lagrandecode/esp-drone-s3-pcb/production/render_bottom.png

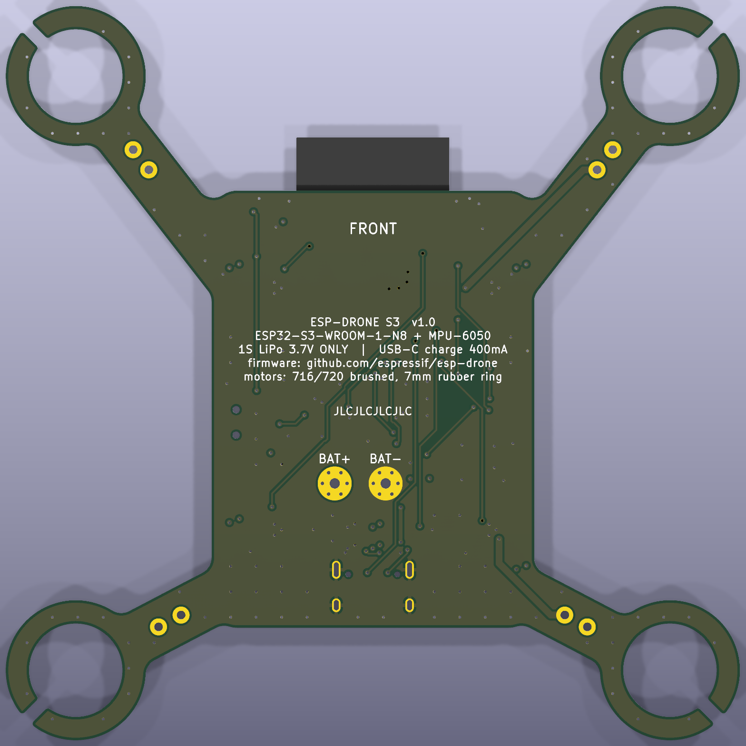
production/render_bottom.png
