lagrandecode/esp-drone-s3-pcb/production/render_iso.png

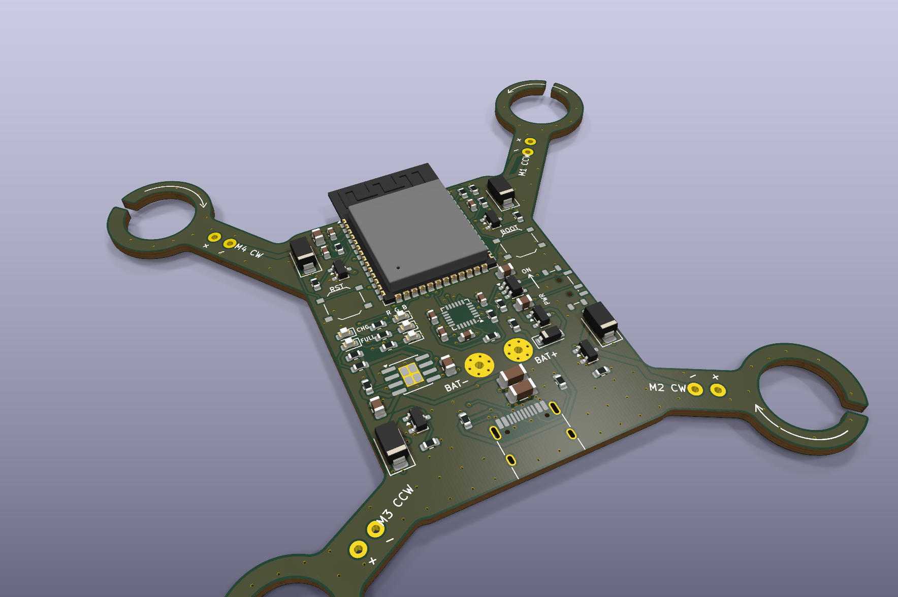
production/render_iso.png
