lagrandecode/esp-drone-s3-pcb/production/esp_drone_s3_bom.csv

Comment | Designator | Footprint | LCSC Part # | Quantity
1uF | C1 | C_0603_1608Metric | C15849 | 1
22uF | C2 | C_0805_2012Metric | C45783 | 1
100nF | C3,C10,C12,C14 | C_0603_1608Metric | C14663 | 4
10uF | C4,C5,C6,C7 | C_0805_2012Metric | C15850 | 4
47uF | C8,C9 | C_1206_3216Metric | C96123 | 2
10nF | C11 | C_0603_1608Metric | C57112 | 1
2.2nF | C13 | C_0603_1608Metric | C1604 | 1
SS34 | D1,D2,D3,D4 | D_SMA | C8678 | 4
B5819W | D5 | D_SOD-123 | C8598 | 1
USB-C | J1 | USB_C_Receptacle_HRO_TYPE-C-31-M-12 | C165948 | 1
RED | LED1,LED4 | LED_0603_1608Metric | C2286 | 2
GREEN | LED2,LED5 | LED_0603_1608Metric | C12624 | 2
BLUE | LED3 | LED_0603_1608Metric | C2288 | 1
AO3400A | Q1,Q2,Q3,Q4 | SOT-23 | C20917 | 4
AO3401A | Q5 | SOT-23 | C15127 | 1
5.1k | R1,R2 | R_0603_1608Metric | C23186 | 2
3k | R3 | R_0603_1608Metric | C4211 | 1
1k | R4,R5 | R_0603_1608Metric | C21190 | 2
470R | R6 | R_0603_1608Metric | C23179 | 1
100R | R7,R8 | R_0603_1608Metric | C22775 | 2
10k | R9,R10,R16,R17,R18,R19 | R_0603_1608Metric | C25804 | 6
4.7k | R11,R12 | R_0603_1608Metric | C23162 | 2
100k | R13,R14,R15,R20 | R_0603_1608Metric | C25803 | 4
BOOT/RESET | SW1,SW2 | SW_Push_1P1T_XKB_TS-1187A | C318884 | 2
POWER | SW3 | SW_SPDT_Shouhan_MSK12C02 | C431540 | 1
ESP32-S3-WROOM-1-N8 | U1 | ESP32-S3-WROOM-1 | C2913198 | 1
MPU-6050 | U2 | InvenSense_QFN-24_4x4mm_P0.5mm | C24112 | 1
TP4056 | U3 | SOIC-8-1EP_3.9x4.9mm_P1.27mm_EP2.41x3.3mm | C16581 | 1
AP2112K-3.3 | U4 | SOT-23-5 | C51118 | 1
