lagrandecode/esp-drone-s3-pcb/(list of files, drawings)

Other design files:
tools/easyeda_pads.json
