lagrandecode/esp-drone-s3-pcb/kicad/esp_drone_s3.kicad_pcb

## KiCad design kicad/esp_drone_s3.kicad_pcb (2026-11-05)

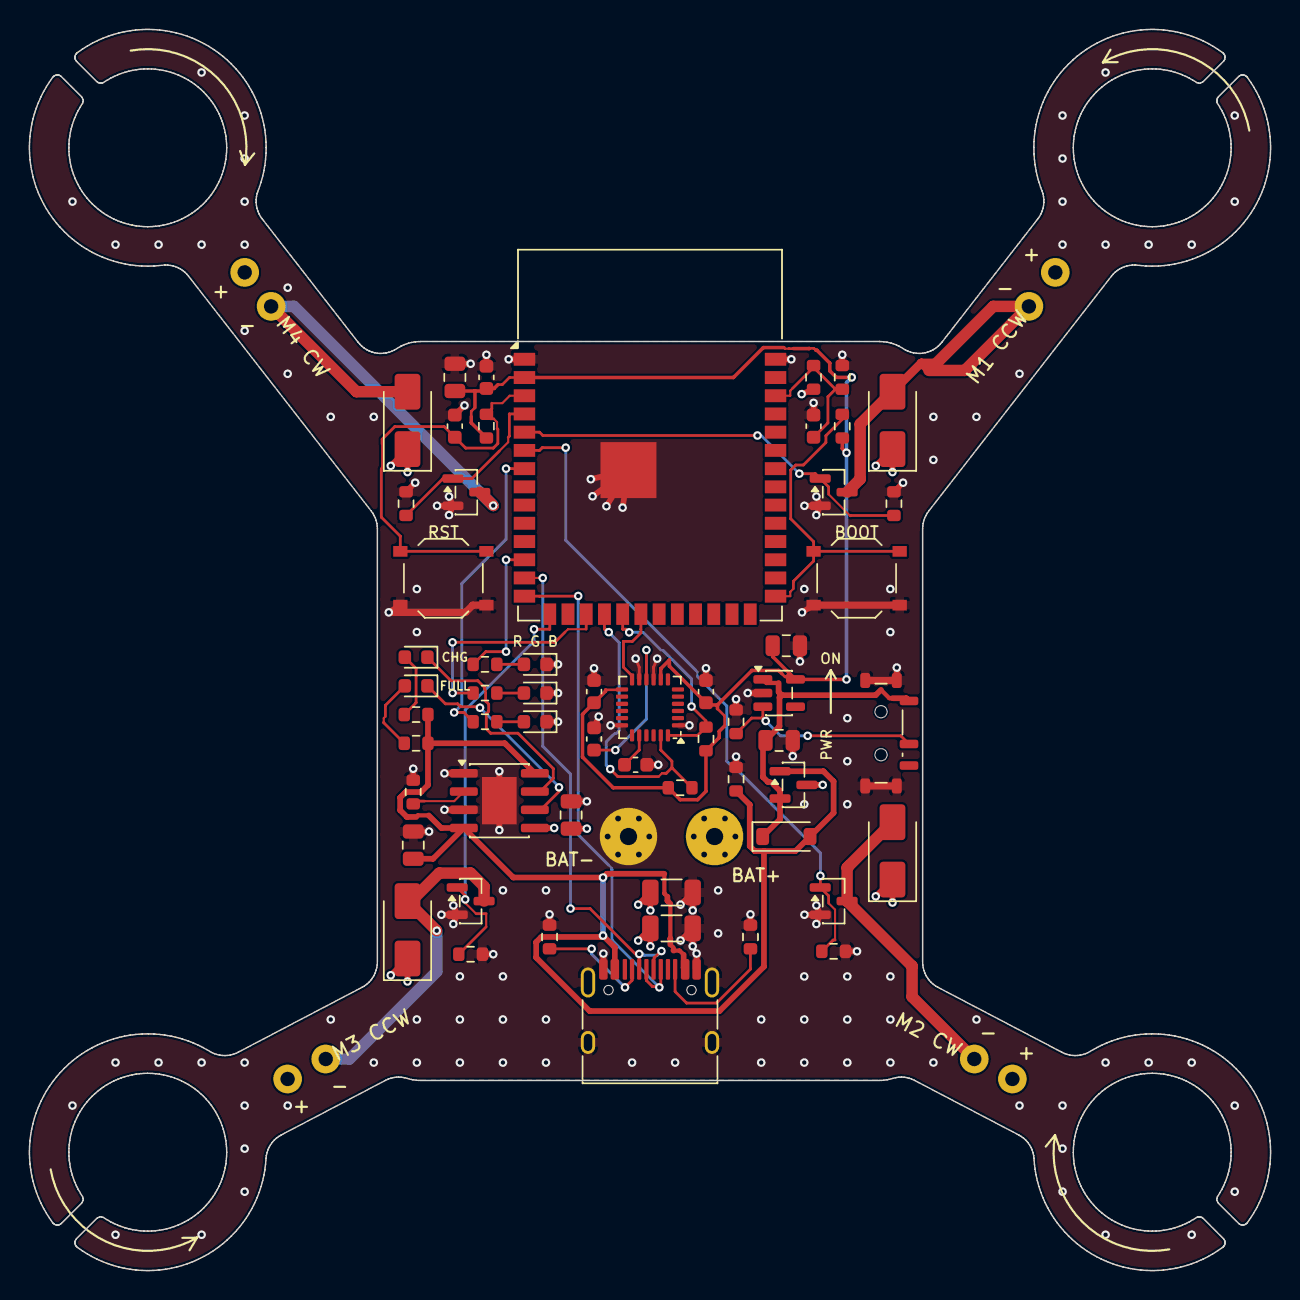
[picture p4: board esp_drone_s3.kicad_pcb from above]

Board: 4 copper layers, 86.5 x 86.5 mm, 62 parts (0 on the bottom side), 37 nets.

Parts:
BT1: BATTERY; BATTERY_PADS
C1: 1uF; C_0603_1608Metric
C2: 22uF; C_0805_2012Metric
C3, C10, C12, C14: 100nF; C_0603_1608Metric
C4, C5, C6, C7: 10uF; C_0805_2012Metric
C8, C9: 47uF; C_1206_3216Metric
C11: 10nF; C_0603_1608Metric
C13: 2.2nF; C_0603_1608Metric
D1, D2, D3, D4: SS34; D_SMA
D5: B5819W; D_SOD-123
J1: USB-C; USB_C_Receptacle_HRO_TYPE-C-31-M-12
LED1, LED4: RED; LED_0603_1608Metric
LED2, LED5: GREEN; LED_0603_1608Metric
LED3: BLUE; LED_0603_1608Metric
M1, M2, M3, M4: MOTOR; MOTOR_PADS
Q1, Q2, Q3, Q4: AO3400A; SOT-23
Q5: AO3401A; SOT-23
R1, R2: 5.1k; R_0603_1608Metric
R3: 3k; R_0603_1608Metric
R4, R5: 1k; R_0603_1608Metric
R6: 470R; R_0603_1608Metric
R7, R8: 100R; R_0603_1608Metric
R9, R10, R16, R17, R18, R19: 10k; R_0603_1608Metric
R11, R12: 4.7k; R_0603_1608Metric
R13, R14, R15, R20: 100k; R_0603_1608Metric
SW1: BOOT; SW_Push_1P1T_XKB_TS-1187A
SW2: RESET; SW_Push_1P1T_XKB_TS-1187A
SW3: POWER; SW_SPDT_Shouhan_MSK12C02
U1: ESP32-S3-WROOM-1-N8; ESP32-S3-WROOM-1
U2: MPU-6050; InvenSense_QFN-24_4x4mm_P0.5mm
U3: TP4056; SOIC-8-1EP_3.9x4.9mm_P1.27mm_EP2.41x3.3mm
U4: AP2112K-3.3; SOT-23-5

Connections:
3V3: C2.1, C3.1, C5.1, C10.1, C11.1, R9.1, R10.1, R11.1, R12.1, U1.2, U2.8, U2.13, U4.5
BOOT: R10.2, SW1.1, U1.27
CC1: J1.A5, R1.1
CC2: J1.B5, R2.1
CHG_CHRG: LED4.1, U3.7
CHG_STDBY: LED5.1, U3.6
EN: C1.1, R9.2, SW2.1, U1.3
GND: BT1.2, C1.2, C2.2, C3.2, C4.2, C5.2, C6.2, C7.2, C8.2, C9.2, C10.2, C11.2, C12.2, C13.2, C14.2, J1.A1, J1.A12, J1.B1, J1.B12, J1.SH, LED1.1, LED2.1, LED3.1, Q1.2, Q2.2, Q3.2, Q4.2, R1.2, R2.2, R3.2, R14.2, R15.2, R16.2, R17.2, R18.2, R19.2, R20.2, SW1.2, SW2.2, SW3.SH, U1.1, U1.40, U1.41, U2.1, U2.9, U2.11, U2.18, U3.1, U3.3, U3.9, U4.2
I2C_SCL: R12.2, U1.18, U2.23
I2C_SDA: R11.2, U1.19, U2.24
IMU_INT: U1.20, U2.12
LDO_EN: R20.1, SW3.2, U4.3
LED4_A: LED4.2, R4.1
LED5_A: LED5.2, R5.1
LED_B: R8.1, U1.7
LED_B_A: LED3.2, R8.2
LED_G: R7.1, U1.17
LED_G_A: LED2.2, R7.2
LED_R: R6.1, U1.12
LED_R_A: LED1.2, R6.2
MOT1_N: D1.2, M1.2, Q1.3
MOT1_PWM: Q1.1, R16.1, U1.5
MOT2_N: D2.2, M2.2, Q2.3
MOT2_PWM: Q2.1, R17.1, U1.6
MOT3_N: D3.2, M3.2, Q3.3
MOT3_PWM: Q3.1, R18.1, U1.15
MOT4_N: D4.2, M4.2, Q4.3
MOT4_PWM: Q4.1, R19.1, U1.4
MPU_CPOUT: C13.1, U2.20
MPU_REGOUT: C12.1, U2.10
TP_PROG: R3.1, U3.2
USB_DN: J1.A7, J1.B7, U1.13
USB_DP: J1.A6, J1.B6, U1.14
VBAT: BT1.1, C7.1, C8.1, C9.1, D1.1, D2.1, D3.1, D4.1, M1.1, M2.1, M3.1, M4.1, Q5.3, R13.1, U3.5
VBAT_ADC: C14.1, R13.2, R14.1, U1.38
VBUS: C6.1, D5.2, J1.A4, J1.A9, J1.B4, J1.B9, Q5.1, R4.2, R5.2, R15.1, U3.4, U3.8
VSYS: C4.1, D5.1, Q5.2, SW3.1, U4.1
