lagrandecode/esp-drone-s3-pcb/(commit log)

2026-11-05 ESP32-S3 PCB-frame micro quadcopter: KiCad board, JLCPCB fab files, generator scripts
    4-layer 86.5 mm frame board (ESP32-S3-WROOM-1-N8, MPU-6050, TP4056 USB-C
    charging, AP2112K LDO, 4x AO3400A brushed motor drivers) pinned to the
    esp-drone firmware defaults. Includes Gerbers, BOM and corrected CPL for
    JLCPCB assembly, and the scripts that place, route and verify the board.
    [easyeda_pads.json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]
2026-11-06 Add interactive assembly guide for hand soldering
2026-11-06 Add per-board Quantity column to BOM for LCSC BOM tool
    [esp_drone_s3-B_Cu.gbl, esp_drone_s3-B_Mask.gbs, esp_drone_s3-B_Paste.gbp, esp_drone_s3-B_Silkscreen.gbo, esp_drone_s3-Edge_Cuts.gm1, esp_drone_s3-F_Cu.gtl, esp_drone_s3-F_Mask.gts, esp_drone_s3-F_Paste.gtp]
2026-11-06 Add LCSC shopping BOM with in-stock capacitor substitutes; merge duplicate BOM lines
    [easyeda_pads.json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]
2026-11-06 Add Flutter phone controller app for the ESP-Drone firmware
    UDP/CRTP link with 50 Hz setpoints, echo-based link status, acknowledged
    arming via system.forceArm, emergency stop, and persisted flight limits.
